RelozRicardo/ElectronicaPotencia_2026_TP_1er_Cuatrimestre/Electronica de Potencia PPT 1er TP.pdf

# Primer Proyecto Electrónica de Potencia

Alumno: Ricardo Reloz

# Propuesta del proyecto y motivos

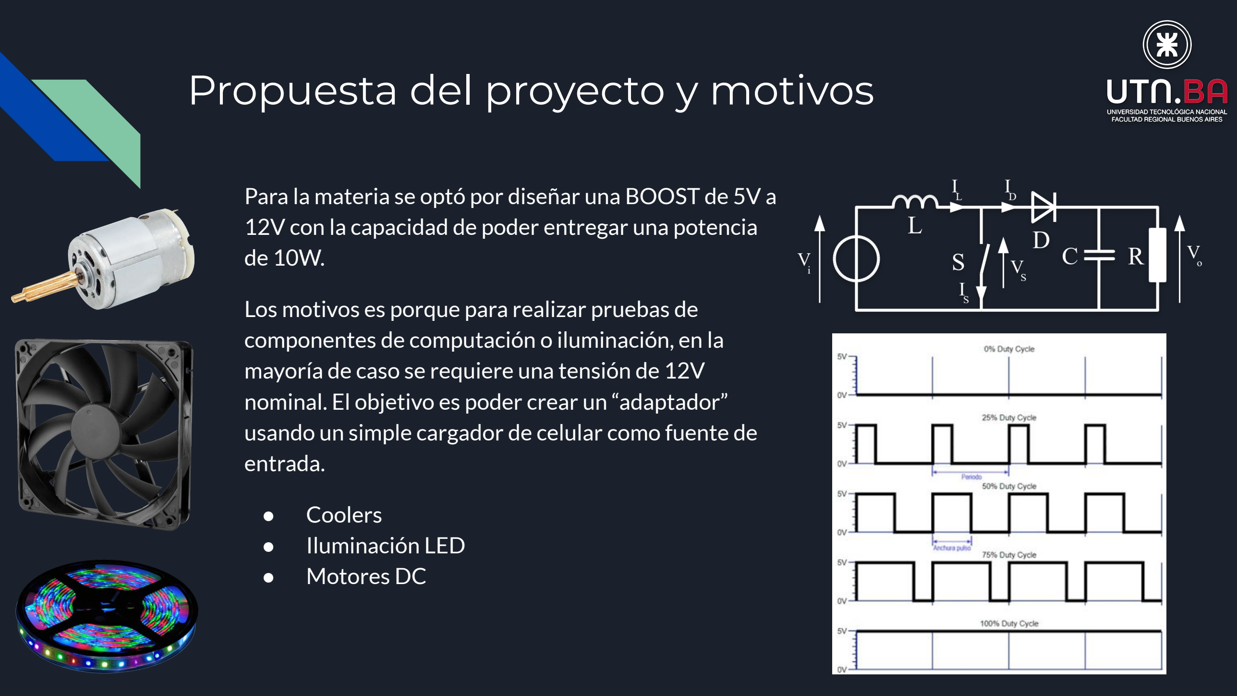
[picture p1: page 2]

Para la materia se optó por diseñar una BOOST de 5V a 12V con la capacidad de poder entregar una potencia de 10W.

Los motivos es porque para realizar pruebas de componentes de computación o iluminación, en la mayoría de caso se requiere una tensión de 12V nominal. El objetivo es poder crear un “adaptador” usando un simple cargador de celular como fuente de entrada.

- Coolers
- Iluminación LED
- Motores DC

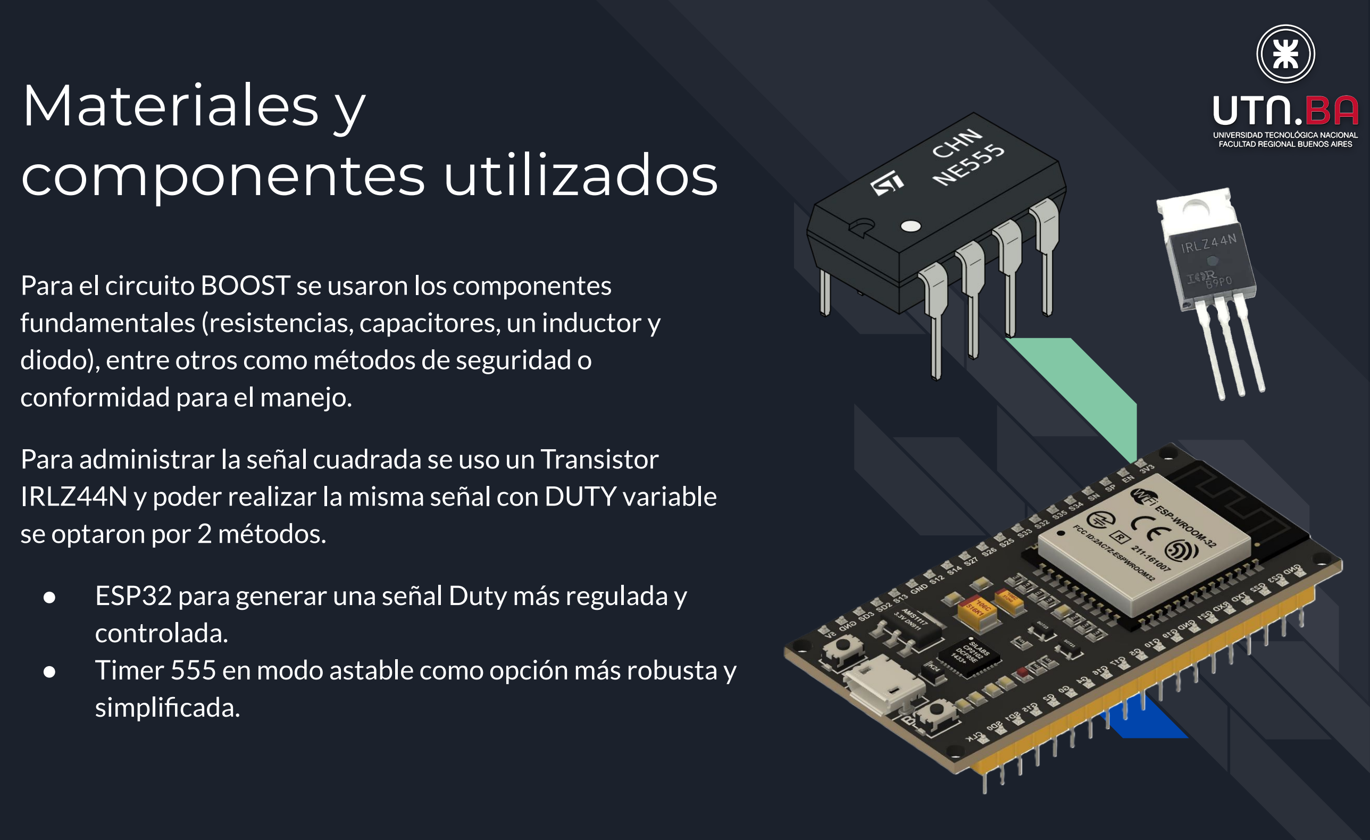
[picture p2: figure]
Materiales y componentes utilizados; conformidad para el manejo.; se optaron por 2 métodos.; controlada.; simplificada.

Para el circuito BOOST se usaron los componentes fundamentales (resistencias, capacitores, un inductor y diodo), entre otros como métodos de seguridad o

Para administrar la señal cuadrada se uso un Transistor IRLZ44N y poder realizar la misma señal con DUTY variable

- ESP32 para generar una señal Duty más regulada y
- Timer 555 en modo astable como opción más robusta y

# Diseño Esquemático y de Placa

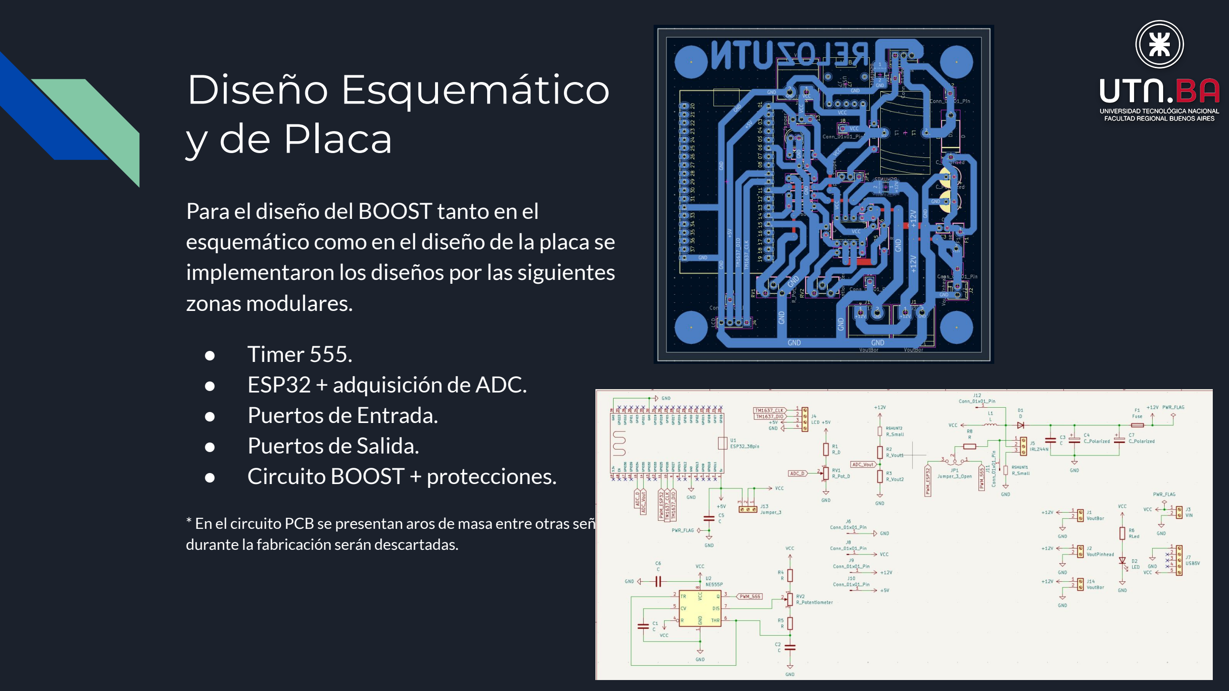
[picture p3: page 4]

Para el diseño del BOOST tanto en el esquemático como en el diseño de la placa se implementaron los diseños por las siguientes zonas modulares.

- Timer 555.
- ESP32 + adquisición de ADC.
- Puertos de Entrada.
- Puertos de Salida.
- Circuito BOOST + protecciones.

* En el circuito PCB se presentan aros de masa entre otras señales, durante la fabricación serán descartadas.

# PCB luego de ser realizada y probada

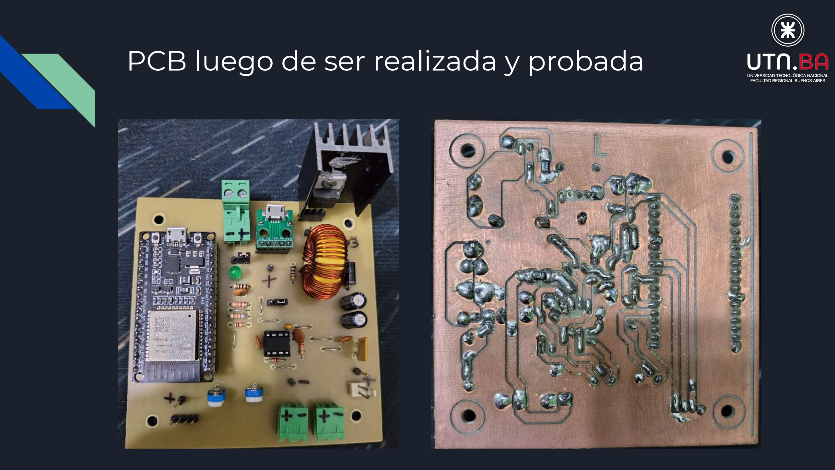
[picture p4: page 5]

# Fotos de Funcionamiento

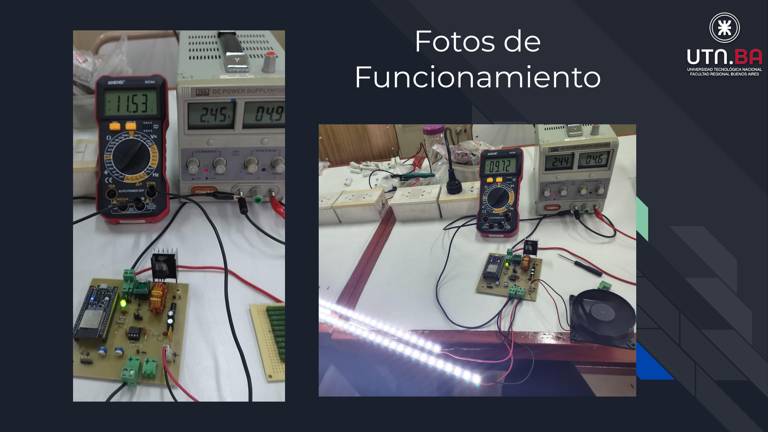
[picture p5: page 6]

# Gráficos de Osciloscopio

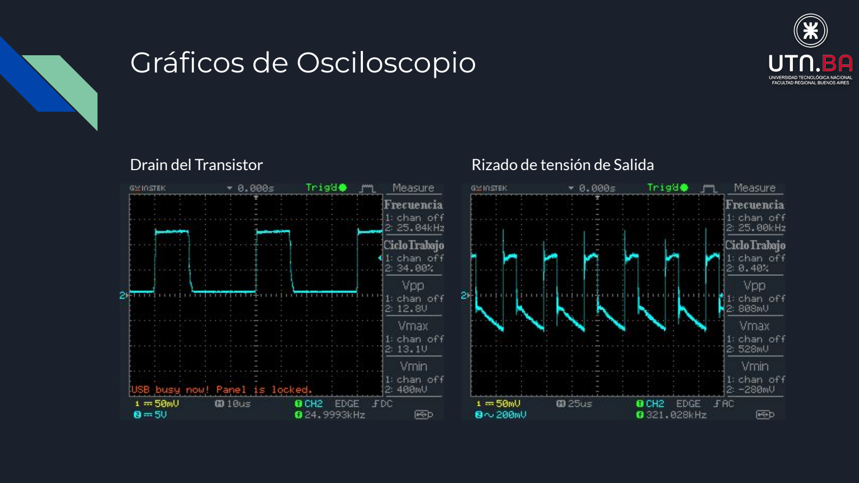
[picture p6: page 7]

Drain del Transistor | Rizado de tensión de Salida

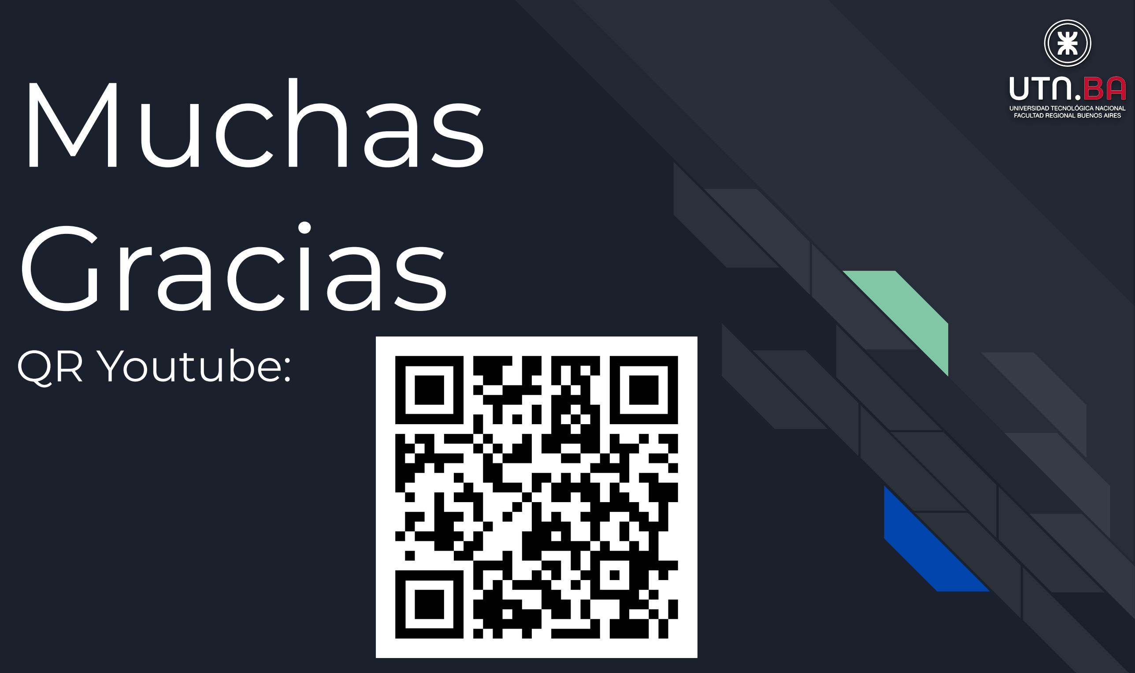
[picture p7: figure]
Muchas Gracias; QR Youtube:
