RelozRicardo/ElectronicaPotencia_2026_TP_1er_Cuatrimestre/LTSPICE/Test_1er.asc

C1: cap; 147µ
D1: diode
L1: ind; 98µ
M1: nmos; IRL3915
R1: res; 37.5
R2: res; 1
V1: voltage; 5
V2: voltage; PULSE(0 5 0 10n 10n {D*T} {T})
Named nets: 0, Vin, Vout, Vpwm
NOTA: (Buscar IRLZ44N)
Modelo Similar 
para simulacion
 
D Teorico = 0.583
.param F=25000
.param T = 1/F
.param D=0.583
.param Pout = 9.6
.param Rout = 144/Pout
.param Cap = 194.44u
.tran 0 0.05 0 0.05
