RelozRicardo/ElectronicaPotencia_2026_TP_1er_Cuatrimestre/Kicad/Boost/Boost.kicad_pcb

## KiCad design Kicad/Boost/Boost.kicad_pcb (2026-07-10)

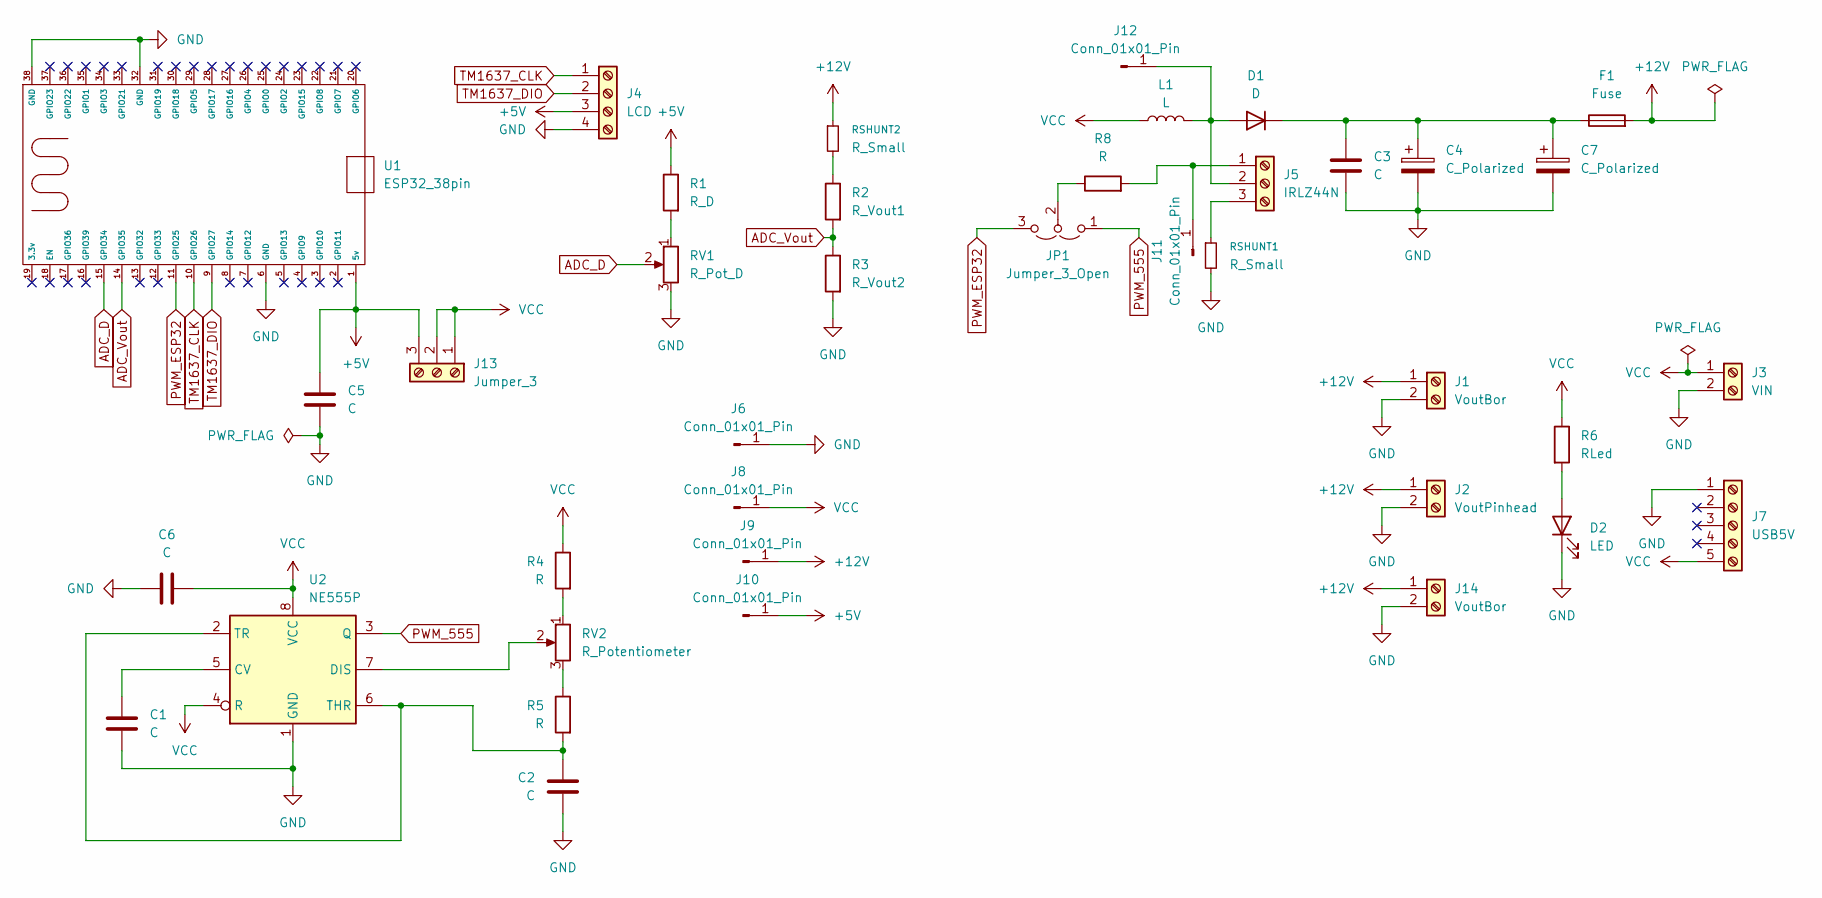
[picture p8: schematic Boost.kicad_sch]

Parts:
C1, C2, C3, C5, C6: C; C_Disc_D3.8mm_W2.6mm_P2.50mm
C4, C7: C_Polarized; CP_Radial_D6.3mm_P2.50mm
D1: D; D_DO-201_P12.70mm_Horizontal
D2: LED; LED_D5.0mm
F1: Fuse; Fuse_Bourns_MF-RG400
J1, J14: VoutBor; PhoenixContact_MSTBA_2,5_2-G-5,08_1x02_P5.08mm_Horizontal
J2: VoutPinhead; Molex_KK-254_AE-6410-02A_1x02_P2.54mm_Vertical
J3: VIN; PhoenixContact_MSTBA_2,5_2-G-5,08_1x02_P5.08mm_Horizontal
J4: LCD; PinHeader_1x04_P2.54mm_Vertical
J5: IRLZ44N; TerminalBlock_Xinya_XY308-2.54-3P_1x03_P2.54mm_Horizontal
J6, J8, J9, J10, J11, J12: Conn_01x01_Pin; PinHeader_1x01_P2.54mm_Vertical
J7: USB5V; MicroUsb_Arduino
J13: Jumper_3; PinHeader_1x03_P2.54mm_Vertical
JP1: Jumper_3_Open; PinHeader_1x03_P2.54mm_Vertical
L1: L; Inductor_T94_Vertical
R1: R_D; R_Axial_DIN0207_L6.3mm_D2.5mm_P7.62mm_Horizontal
R2: R_Vout1; R_Axial_DIN0207_L6.3mm_D2.5mm_P7.62mm_Horizontal
R3: R_Vout2; R_Axial_DIN0207_L6.3mm_D2.5mm_P7.62mm_Horizontal
R4, R5, R8: R; R_Axial_DIN0207_L6.3mm_D2.5mm_P7.62mm_Horizontal
R6: RLed; R_Axial_DIN0207_L6.3mm_D2.5mm_P7.62mm_Horizontal
RSHUNT1, RSHUNT2: R_Small; R_2010_5025Metric_Pad1.40x2.65mm_HandSolder
RV1: R_Pot_D; Potentiometer_ACP_CA9-H2,5_Horizontal
RV2: R_Potentiometer; Potentiometer_ACP_CA9-H2,5_Horizontal
U1: ESP32_38pin; ESP32Wroom32_38Pines
U2: NE555P; DIP-8_W7.62mm

Connections:
+5V: C5.1, J4.3, J10.1 (Pin_1_1), J13.3, R1.1, U1.1 (5v)
+12V: F1.2, J1.1, J2.1, J9.1 (Pin_1_1), J14.1, RSHUNT2.1
ADC_D: RV1.2, U1.15 (GPIO34)
ADC_Vout: R2.2, R3.1, U1.14 (GPIO35)
GND: C1.2, C2.2, C3.2, C4.2, C5.2, C6.1, C7.2, D2.1 (K), J1.2, J2.2, J3.2, J4.4, J6.1 (Pin_1_1), J7.1, J14.2, R3.2, RSHUNT1.2, RV1.3, U1.6 (GND), U1.32 (GND), U1.38 (GND), U2.1 (GND)
unnamed: D1.2 (A), J5.2, J12.1 (Pin_1_1), L1.2
unnamed: C3.1, C4.1, C7.1, D1.1 (K), F1.1
unnamed: D2.2 (A), R6.2
unnamed: J5.3, RSHUNT1.1
unnamed: J5.1, J11.1 (Pin_1_1), R8.2
unnamed: JP1.2 (C), R8.1
unnamed: R1.2, RV1.1
unnamed: R2.1, RSHUNT2.2
unnamed: R4.2, RV2.1
unnamed: R5.1, RV2.3
unnamed: C1.1, U2.5 (CV)
unnamed: RV2.2, U2.7 (DIS)
unnamed: C2.1, R5.2, U2.2 (TR), U2.6 (THR)
PWM_555: JP1.1 (A), U2.3 (Q)
PWM_ESP32: JP1.3 (B), U1.11 (GPIO25)
TM1637_CLK: J4.1, U1.10 (GPIO26)
TM1637_DIO: J4.2, U1.9 (GPIO27)
VCC: C6.2, J3.1, J7.5, J8.1 (Pin_1_1), J13.1, J13.2, L1.1, R4.1, R6.1, U2.4 (R), U2.8 (VCC)

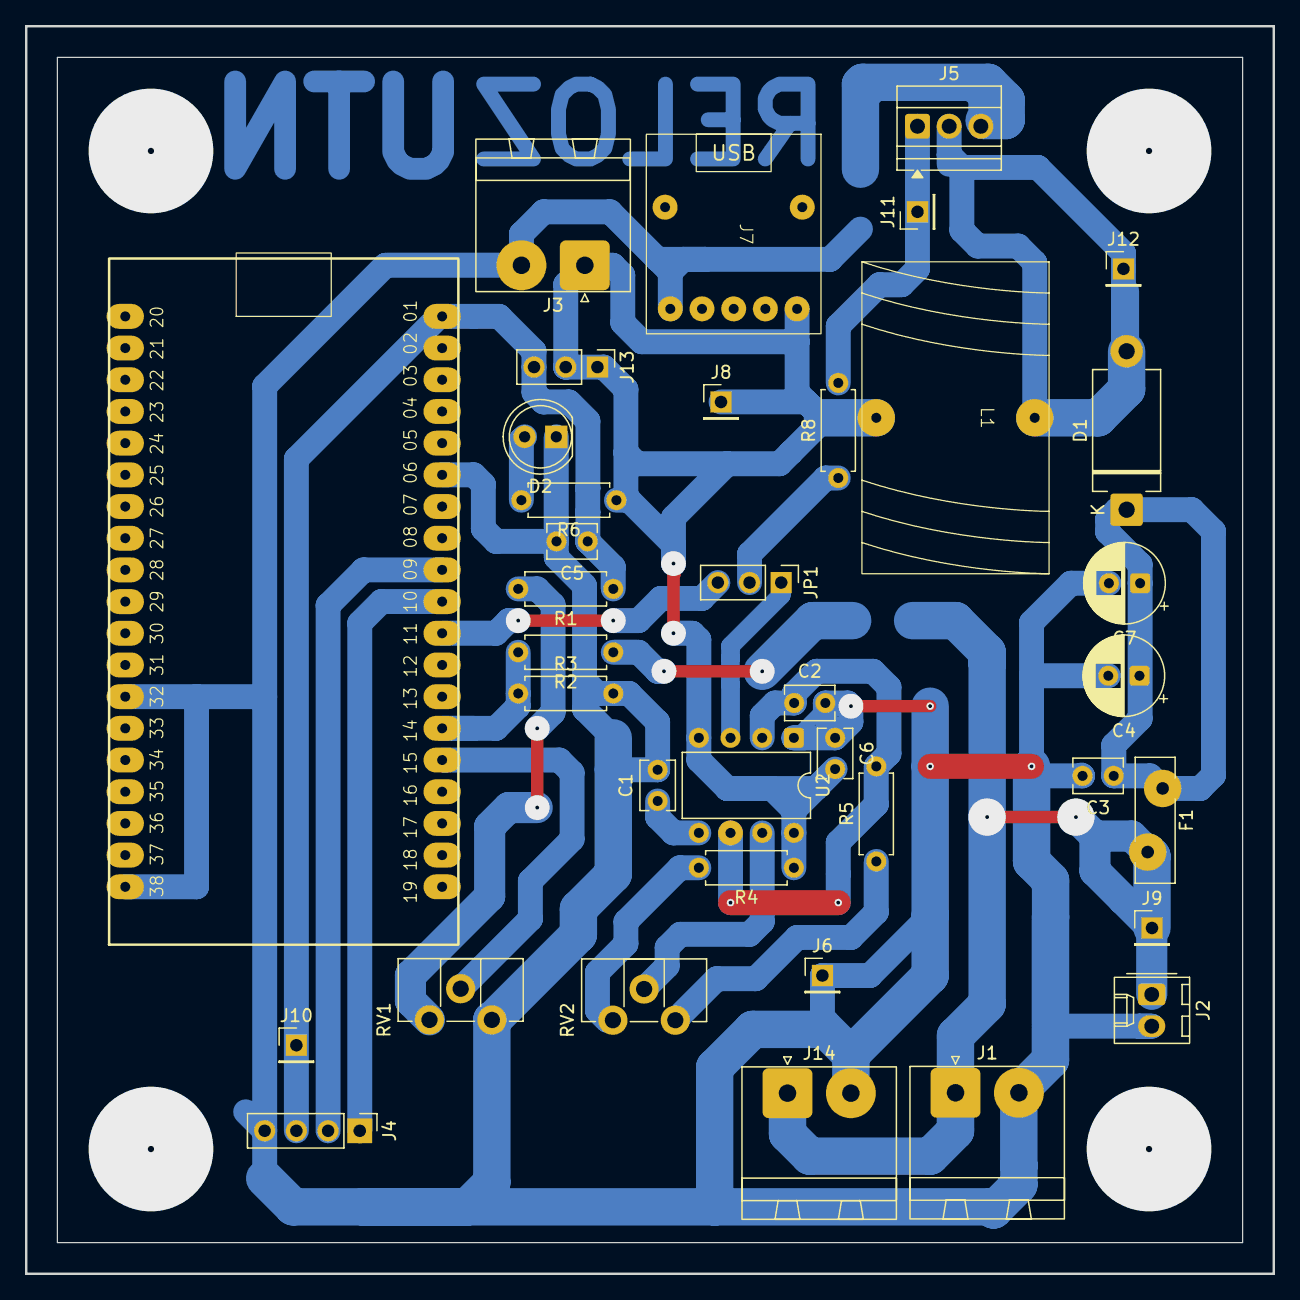
[picture p9: board Boost.kicad_pcb from above]

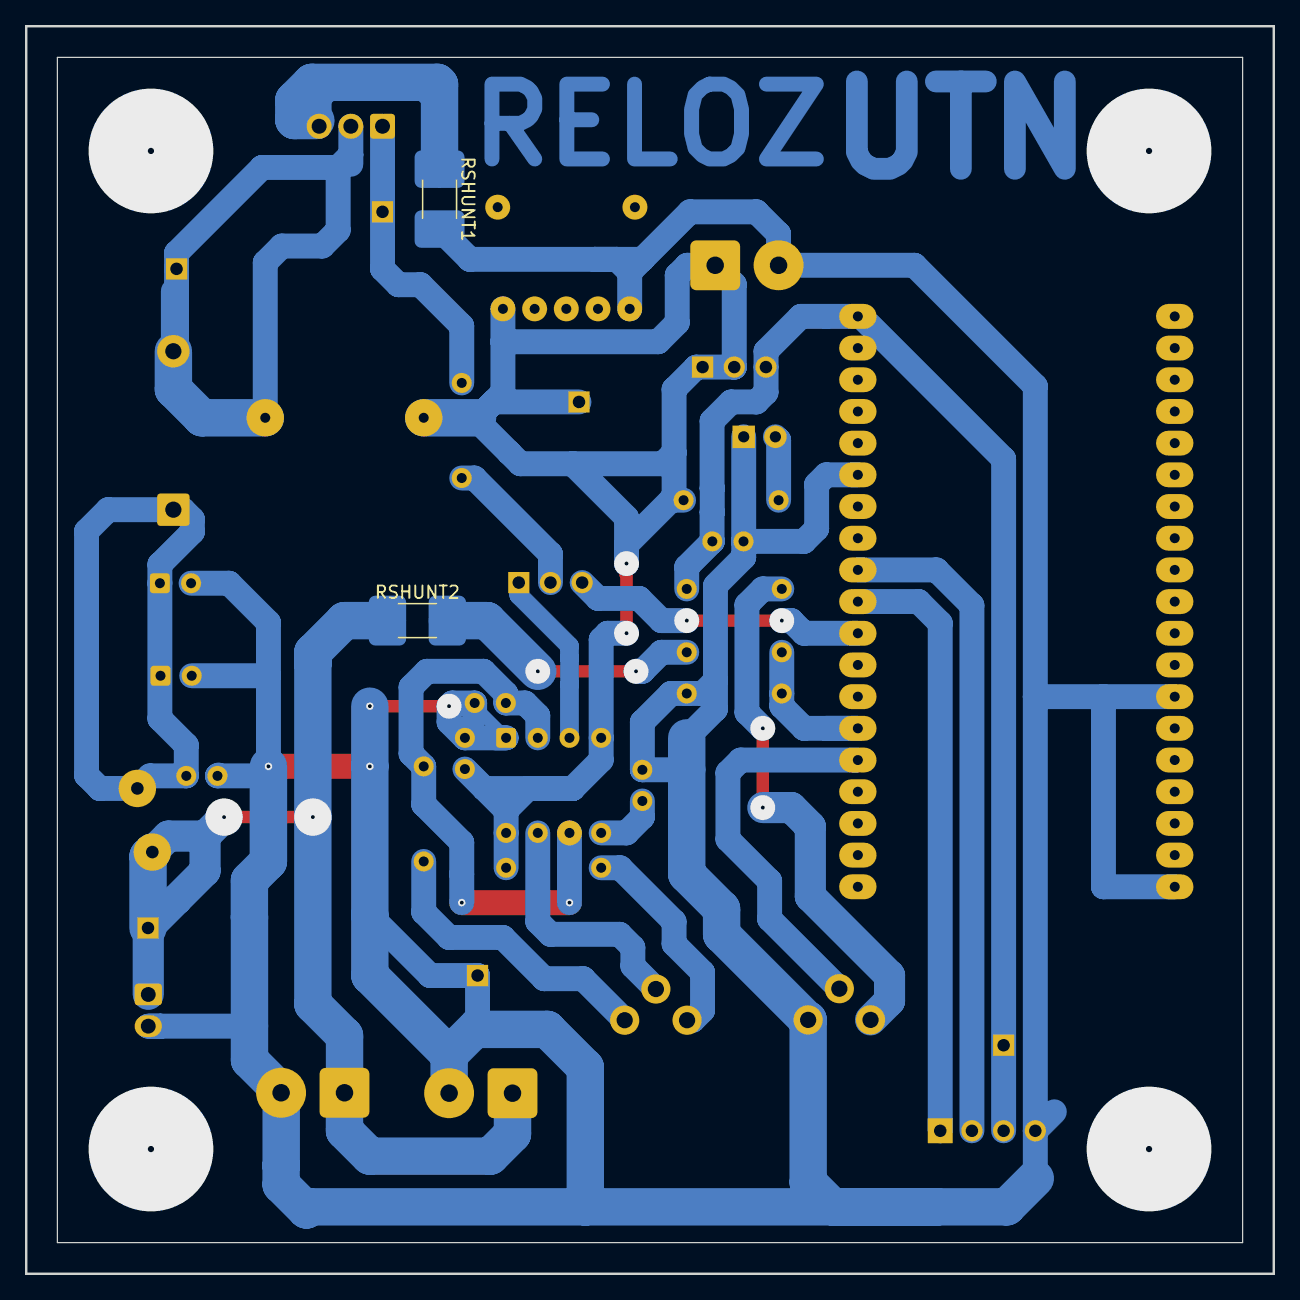
[picture p10: board Boost.kicad_pcb from below]

Board: 2 copper layers, 100.0 x 100.0 mm, 39 parts (2 on the bottom side), 23 nets.
