RelozRicardo/ElectronicaPotencia_2026_TP_1er_Cuatrimestre/(commit log)

2026-07-10 Subida de LTSPICE
2026-07-10 Kicad Archivos
    [Boost.kicad_pcb, Boost.kicad_sch]
